HexabitzPlatform/H1BR6x-Hardware/README.md

# H1BR6x-Hardware
Hexabitz Micro SD Memory Card Module Hardware Design
