HexabitzPlatform/H1BR6x-Hardware/Released/BOM/H1BR61_BOM..xlsx

Qty | Comment | Designator | Description | MFN | MPN | OCTOPART_URL
1 | 5025700893502570-0893_MOL | J2 | 1.10mm Pitch microSD Memory Card Connector, Normal Mount Surface Mount | Molex | 502570-0893 | https://octopart.com/502570-0893-molex-42270318?r=sp
1 | FB-TDK_MMZ1608Y300BTA00 | FB1 | Ind chip Bead Multi-Layer 30 ohms 25% 100MHZ Ferrite 1,5A 0603Punched paper T/R | TDK | MMZ1608Y300BTA00 | https://octopart.com/mmz1608y300bta00-tdk-7906990?r=sp
1 | PINHD-1X1 | J4 | PCB Header, Unshrouded, Thru 02 Straight Header, .101, AMPMODU Mod II Series | TE Connectivity | 87227-1 | https://octopart.com/87227-1-te+connectivity-39512052?r=sp
1 | PINHD-1X3 | JP1 | Conn Unshrouded Header HDR 3 POS 2.54mm Solder ST Top Entry Thru-Hole Carton | TE Connectivity | 5-146281-3 | https://octopart.com/5-146281-3-te+connectivity+%2F+amp-39745942?r=sp
1 | 0.0R | R3 | RES SMD 0.0OHM JUMPER 1/10W 0603 | YAGEO [VR] | RC0603JR-070RL | https://octopart.com/rc0603jr-070rl-yageo-1241539?r=sp
5 | 100nF | C1,C2,C4,C5,C7 | CAP CER 0,1UF 16V X7R 0603 | AVX CORPORATION | 0603YC104K4T2A | https://octopart.com/0603yc104k4t2a-avx+interconnect+%2F+elco-8120651
1 | 10K | R2 | RES 10 K OHM 5% 0603 | Vishay | CRCW060310K0JNEB | https://octopart.com/crcw060310k0jneb-vishay-46603269
1 | 1uF | C6 | CAP CER 1UF 16V X7R 0805 | YAGEO [VA] | CC0805KKX7R7BB105 | https://octopart.com/cc0805kkx7r7bb105-yageo-8376555?r=sp
1 | 270R | R1 | Thick Film Resistors - SMD 0603 270ohms 5% Tol | Panasonic | ERJ-3GEYJ271V | https://octopart.com/erj-3geyj271v-panasonic-55560546?r=sp
3 | 4.7uF | C3,C8,C9 | CAP TANT 4.7UF 10V 20% 0805 | Panasonic | 10TPU4R7MSI | https://octopart.com/10tpu4r7msi-panasonic-29487748?r=sp
4 | 4700R | R4,R5,R6,R7 | Thick Film Resistors - SMD 0603 | YAGED [VA] | RC0603JR-074K7L | https://octopart.com/rc0603jr-074k7l-yageo-55458509?r=sp
1 | XTALL_CSTCE8M00G52 | X1 | 8,0000MHZ 33pF SMD MURATA Resonators | Murata | CSTNE8M00G550000R0 | https://octopart.com/cstne8m00g550000r0-murata-91406934?r=sp
1 | VLMS1300-GS08 | D1 | Red 0603 130آ° Clear 54 mcd 2 V Surface Mount ChipLED ; | Vishay | VLMS1300-GS08 | https://octopart.com/vlms1300-gs08-vishay-21709201?r=sp&s=0nXJNjGsSbWwqfqWlZv0EA
1 | STM32G0B1CEU6N | U1 | MCU 32-Bit ARM Cortex-M0+ RISC 512kByte Flash 1.7V to 3.6V 48-Pin UFQFPN Tray | STMicroelectronics | STM32G0B1CEU6N | https://octopart.com/stm32g0b1ceu6n-stmicroelectronics-116364672?r=sp
