HexabitzPlatform/H1BR6x-Hardware/Documentation/H1BR6 Schematics.pdf

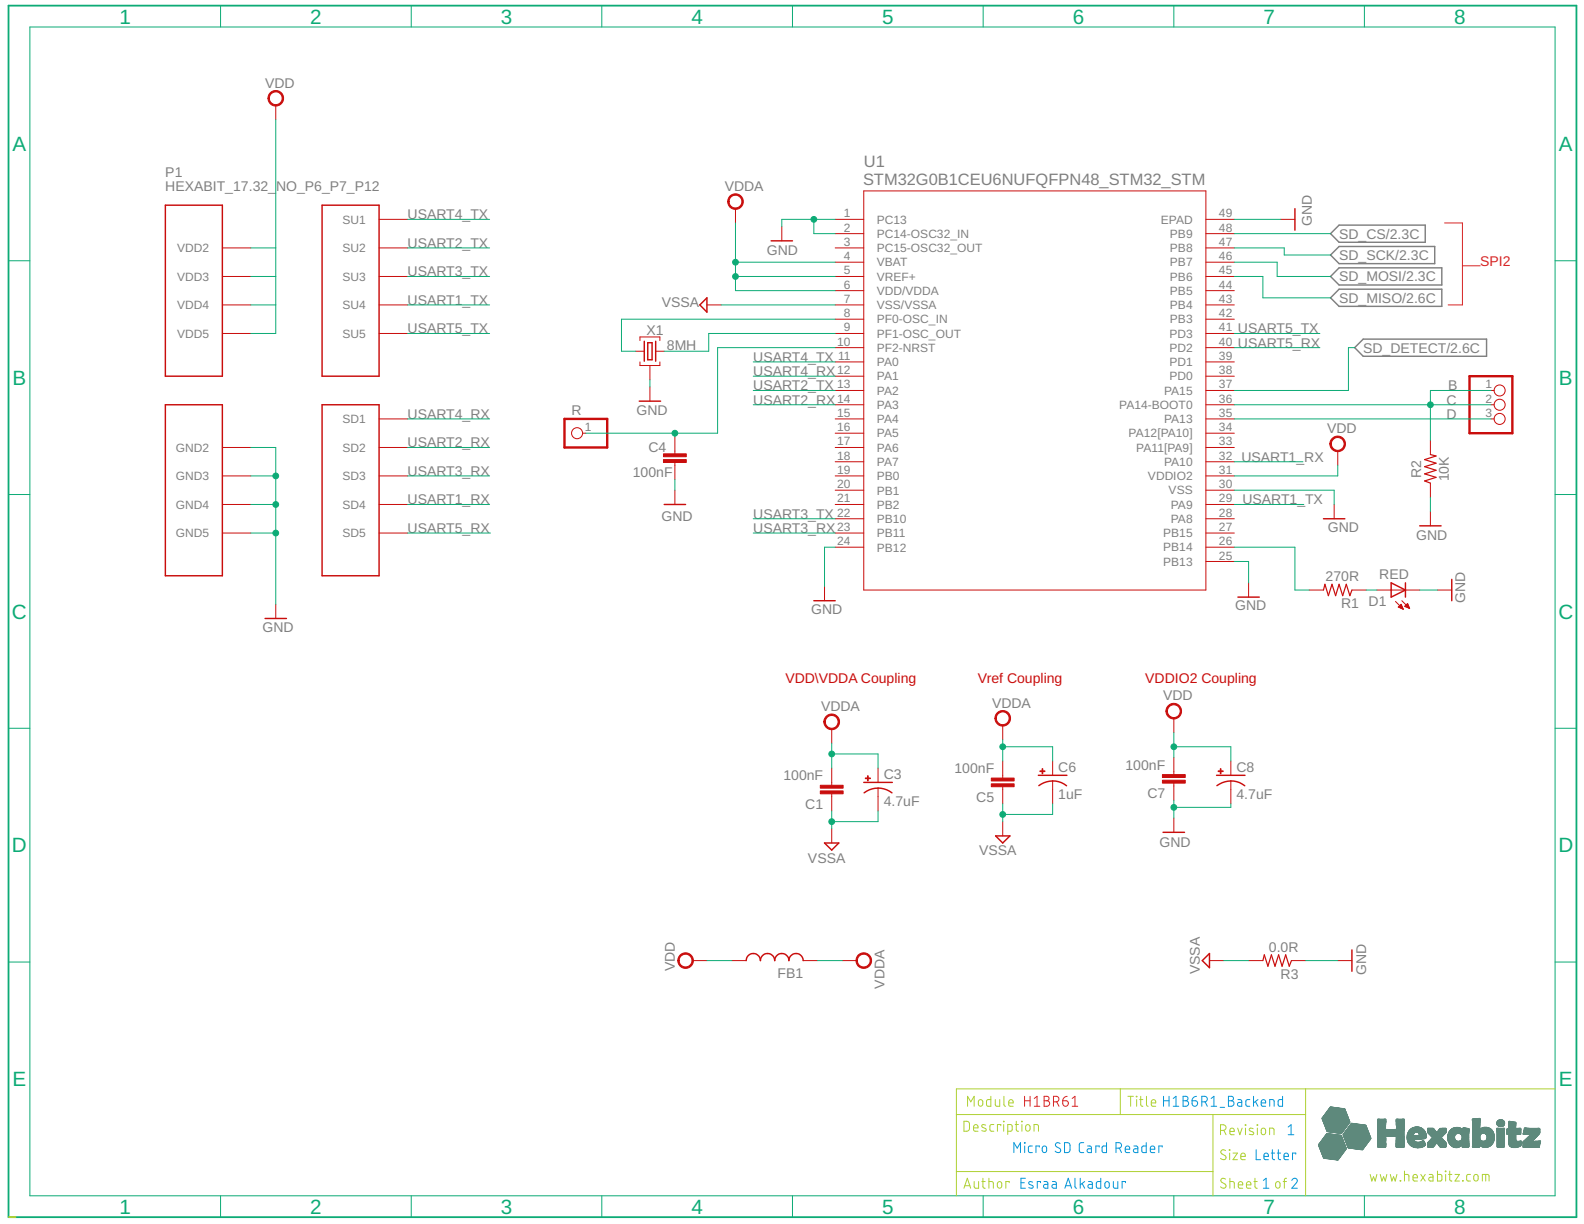
[picture p1: page 1]

35 PA14-BOOT0 | D | 3

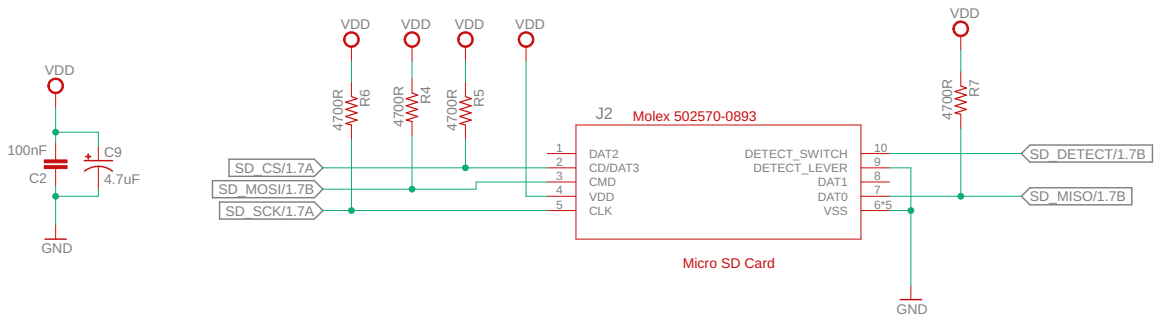
[picture p2: page 2]
