HexabitzPlatform/H1BR6x-Hardware/Design/H1BR6.brd

## EAGLE design Design/H1BR6.brd (2022-04-30)

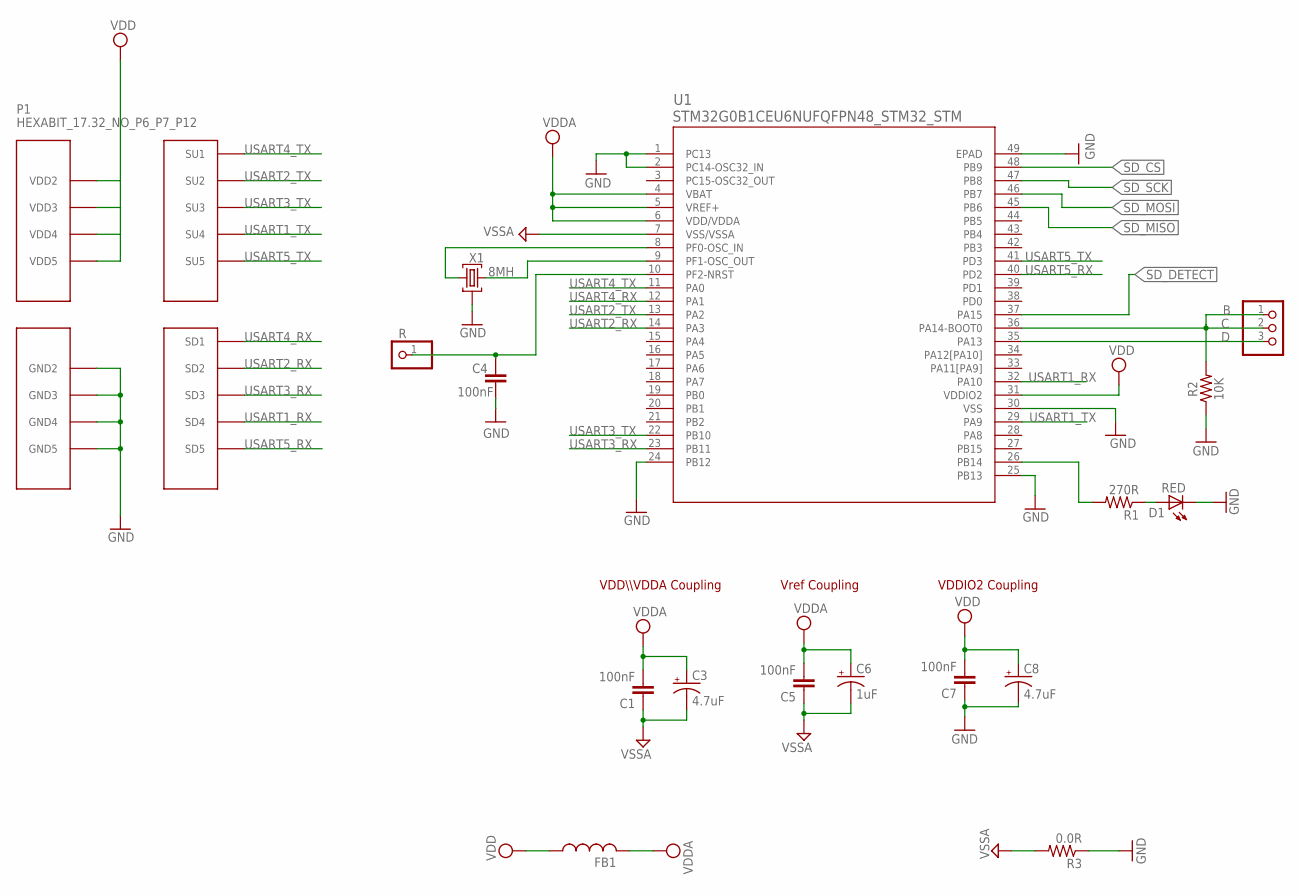
[picture p3: schematic H1BR6.sch, sheet 1]

Parts:
C1, C5, C7: 100nF; C-0603; TOLERANCE 10%; VOLTAGE_RATING 16.0 V; MPN '0603YC104K4T2A
C3: 4.7uF; C-0805-POL; TOLERANCE 20%; VOLTAGE_RATING 10.0 V; MPN '10TPU4R7MSI
C4: 100nF; C-0603; TOLERANCE 10%; VOLTAGE_RATING 16.0 V; MPN 0603YC104K4T2A
C6: 1uF; C-0805-POL; TOLERANCE 20%; VOLTAGE_RATING 10.0 V; MPN 'CC0805KKX7R7BB105
C8: 4.7uF; C-0805-POL; TOLERANCE 10%; VOLTAGE_RATING 16.0 V; MPN '10TPU4R7MSI
D1: RED; VLMS1300-GS08
FB1: FB-TDK_MMZ1608Y300B; MPN MMZ1608Y300BTA00
J4: PINHD-1X1; 1X01
JP1: PINHD-1X3; 1X03
P1: HEXABIT_17.32_NO_P6_P7_P12
R1: 270R; R-0603; MPN 'ERJ-3GEYJ271V
R2: 10K; R-0603; MPN '060300J0103T5E
R3: 0.0R; R-0603; MPN RC0603JR-070RL
U1: STM32G0B1CEU6NUFQFPN48_STM32_STM; UFQFPN48_STM32_STM
X1: 8MH; XTALL_CSTCE8M00G52; MPN CSTNE8M00G550000R0

Connections:
C: JP1.1, JP1.2, R2.2, U1.36 (PA14-BOOT0)
D: JP1.3, U1.35 (PA13)
GND: C4.1, C7.1, C8.2 (-), D1.C, P1.PAD_PD8 (GND2), P1.PAD_PD9 (GND3), P1.PAD_PD10 (GND4), P1.PAD_PD11 (GND5), R2.1, R3.1, U1.1 (PC13), U1.2 (PC14-OSC32_IN), U1.24 (PB12), U1.25 (PB13), U1.30 (VSS), U1.49 (EPAD), X1.P$2 (2); also elsewhere on the board
GND1: C1.1, C3.2 (-), C5.1, C6.2 (-), R3.2, U1.7 (VSS/VSSA)
unnamed: U1.8 (PF0-OSC_IN), X1.P$3 (3)
unnamed: U1.9 (PF1-OSC_OUT), X1.P$1 (1)
unnamed: R1.2, U1.26 (PB14)
unnamed: D1.A, R1.1
R: C4.2, J4.1, U1.10 (PF2-NRST)
SD_CS: U1.48 (PB9); also elsewhere on the board
SD_DETECT: U1.37 (PA15); also elsewhere on the board
SD_MISO: U1.45 (PB6); also elsewhere on the board
SD_MOSI: U1.46 (PB7); also elsewhere on the board
SD_SCK: U1.47 (PB8); also elsewhere on the board
USART1_RX: P1.PAD_PD4 (SD4), U1.32 (PA10)
USART1_TX: P1.PAD_PU4 (SU4), U1.29 (PA9)
USART2_RX: P1.PAD_PD2 (SD2), U1.14 (PA3)
USART2_TX: P1.PAD_PU2 (SU2), U1.13 (PA2)
USART3_RX: P1.PAD_PD3 (SD3), U1.23 (PB11)
USART3_TX: P1.PAD_PU3 (SU3), U1.22 (PB10)
USART4_RX: P1.PAD_PD1 (SD1), U1.12 (PA1)
USART4_TX: P1.PAD_PU1 (SU1), U1.11 (PA0)
USART5_RX: P1.PAD_PD5 (SD5), U1.40 (PD2)
USART5_TX: P1.PAD_PU5 (SU5), U1.41 (PD3)
VCC: C1.2, C3.1 (+), C5.2, C6.1 (+), FB1.2, U1.4 (VBAT), U1.5 (VREF+), U1.6 (VDD/VDDA)
VDD: C7.2, C8.1 (+), FB1.1, P1.PAD_PU8 (VDD2), P1.PAD_PU9 (VDD3), P1.PAD_PU10 (VDD4), P1.PAD_PU11 (VDD5), U1.31 (VDDIO2); also elsewhere on the board

Notes on the sheet:
VDDIO2 Coupling
VDD\\\VDDA Coupling
Vref Coupling

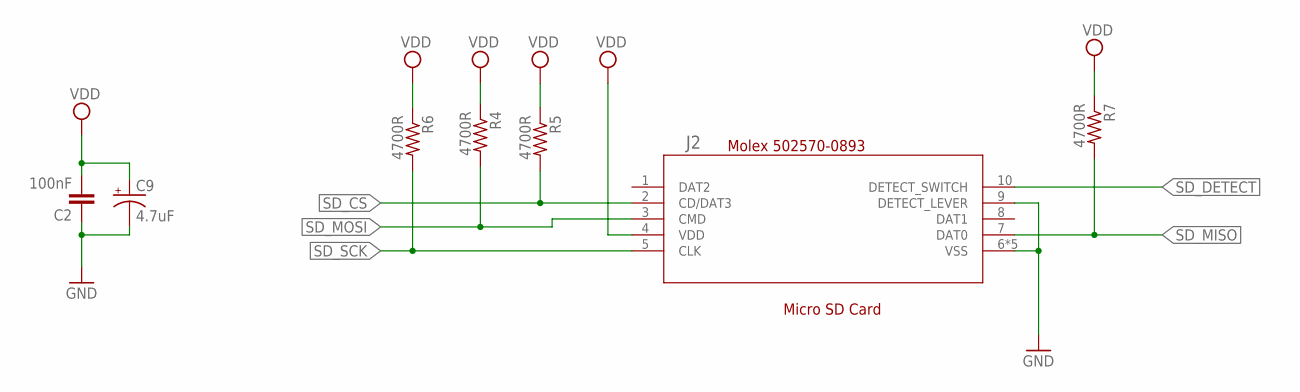
[picture p4: schematic H1BR6.sch, sheet 2]

Parts:
C2: 100nF; C-0603; TOLERANCE 10%; VOLTAGE_RATING 16.0 V; MPN '0603YC104K4T2A
C9: 4.7uF; C-0805-POL; TOLERANCE 20%; VOLTAGE_RATING 10.0 V; MPN '10TPU4R7MSI
J2: 5025700893502570-0893_MOL; 502570-0893_MOL
R4, R5, R6, R7: 4700R; R-0603; TOLERANCE 5%; MPN RC0603JR-074K7L

Connections:
GND: C2.1, C9.2 (-), J2.6 (VSS), J2.9 (DETECT_LEVER), J2.11 (VSS), J2.12 (VSS), J2.13 (VSS), J2.14 (VSS); also elsewhere on the board
SD_CS: J2.2 (CD/DAT3), R5.2; also elsewhere on the board
SD_DETECT: J2.10 (DETECT_SWITCH); also elsewhere on the board
SD_MISO: J2.7 (DAT0), R7.2; also elsewhere on the board
SD_MOSI: J2.3 (CMD), R4.2; also elsewhere on the board
SD_SCK: J2.5 (CLK), R6.2; also elsewhere on the board
VDD: C2.2, C9.1 (+), J2.4 (VDD), R4.1, R5.1, R6.1, R7.1; also elsewhere on the board

Notes on the sheet:
Micro SD Card
Molex 502570-0893

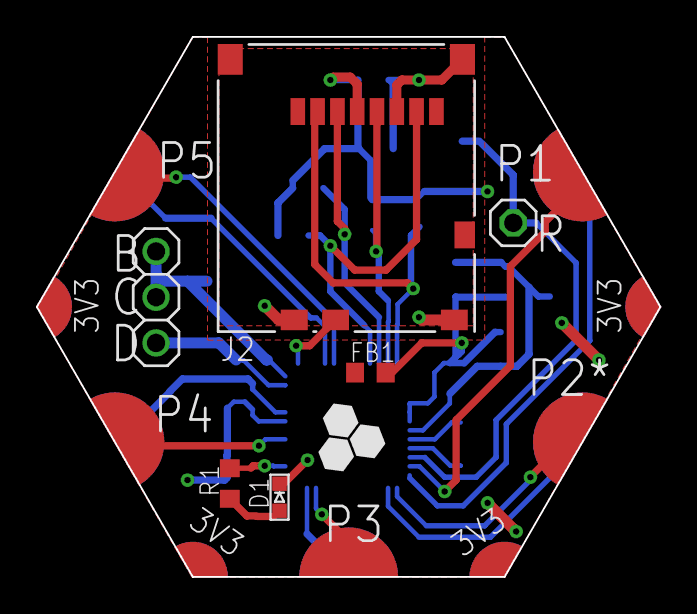
[picture p5: board H1BR6.brd from above]

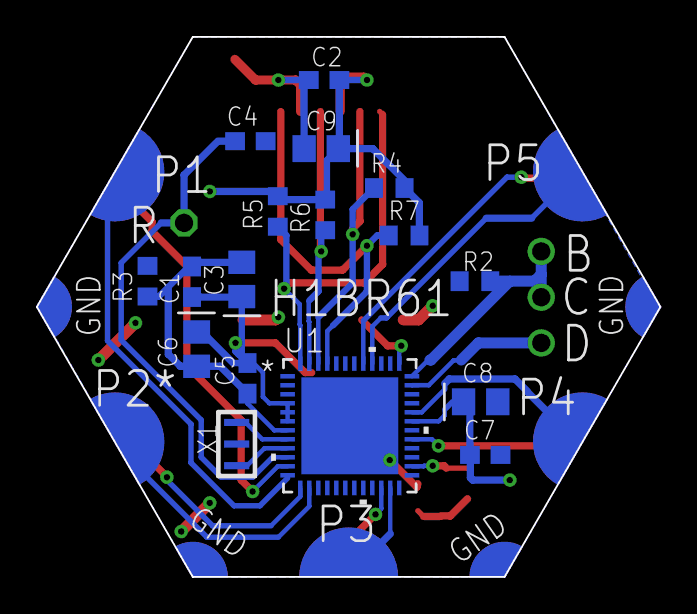
[picture p6: board H1BR6.brd from below]

Board: 2 copper layers, 34.6 x 30.0 mm, 24 parts (17 on the bottom side), 26 nets.
