HexabitzPlatform/H1BR6x-Hardware/(commit log)

2022-04-30 -Changing the MC with STM32G0
    [H1BR61.brd, H1BR61.sch, H1BR61_BOM..xlsx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]
2022-08-23 Correcting Schematic file
    [H1BR61.sch]
2023-02-16 -Correcting some documentaion issues
    [H1BR61.sch, H1BR61_BOM..xlsx]
2024-03-07 Fix some documentation issues
    [H1BR6.brd, H1BR6.sch]
