HexabitzPlatform/H1BR6x-Hardware/(notices)

Notices in the files:
parts and their libraries:
HEXABITZ_CONNECTION_PARTS: COPYRIGHT: Copyright (C) 2022 Ultra Librarian. All rights reserved.
